scottohair/octal/Octal Schematic.pdf

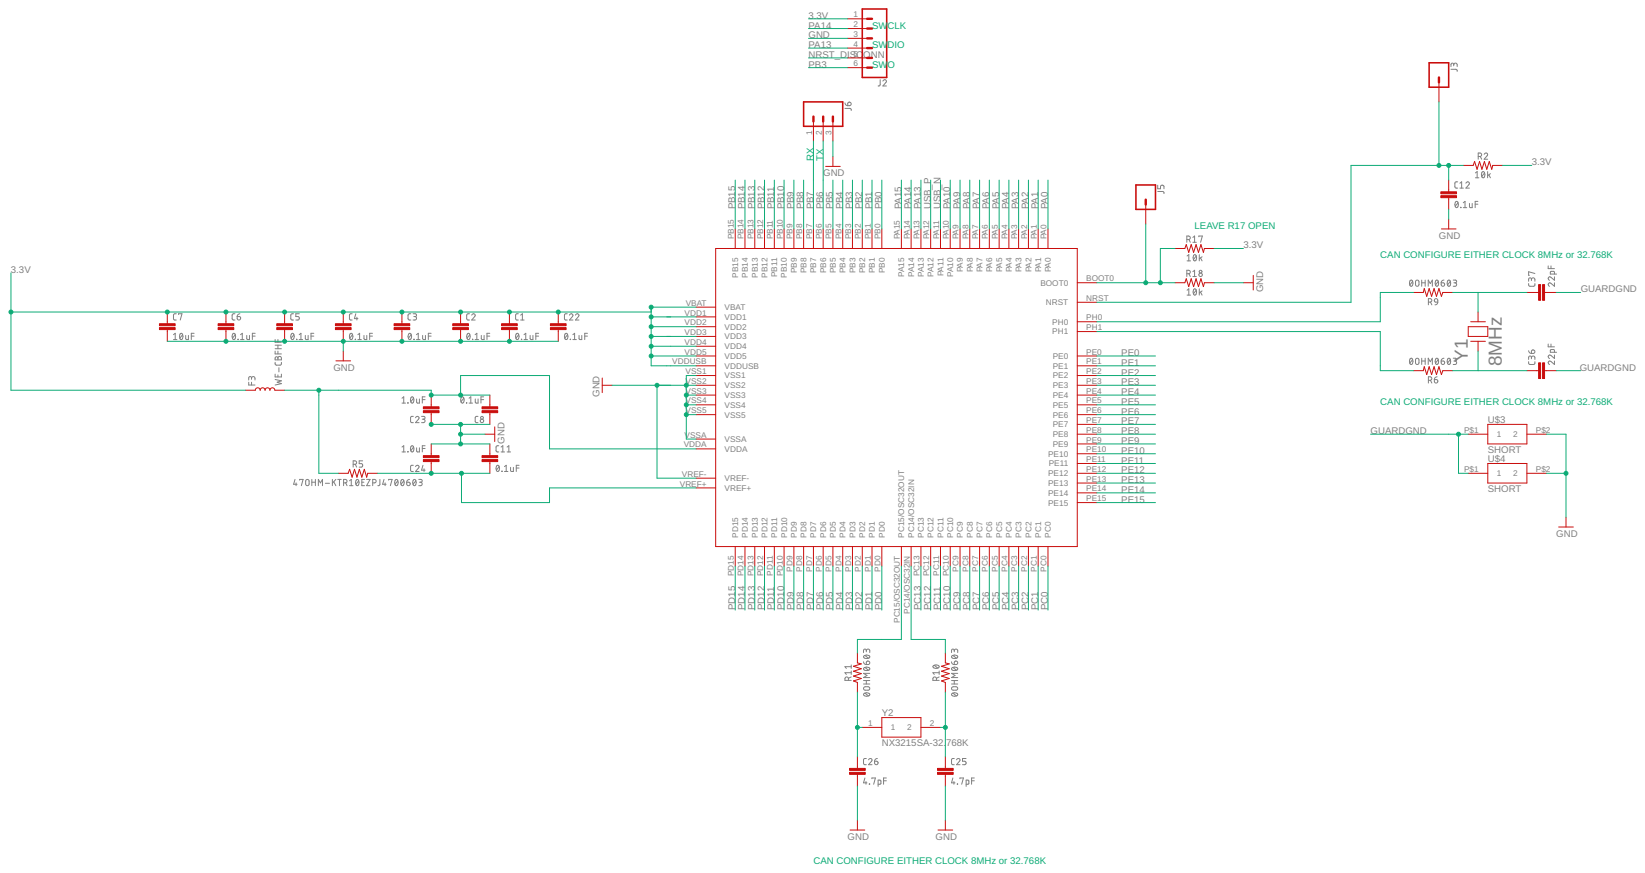
[picture p1: page 1]

8MHz GND GND GND NX3215SA-32.768K GND GND GND GND GND GND SHORT SHORT BOOT0 BOOT0 NRST NRST PA0 PA0 PA1 PA1 PA2 PA2 PA3 PA3 PA4 PA4 PA5 PA5 PA6 PA6 PA7 PA7 PA8 PA8 PA9 PA9 PA10 PA10 PA11 PA11 PA12 PA12 PA13 PA13 PA14 PA14 PA15 PA15 PB0 PB0 PB1 PB1 PB2 PB2 PB3 PB3 PB4 PB4 PB5 PB5 PB6 PB6 PB7 PB7 PB8 PB8 PB9 PB9 PB10 PB10 PB11 PB11 PB12 PB12 PB13 PB13 PB14 PB14 PB15 PB15 PC0 PC0 PC1 PC1 PC2 PC2 PC3 PC3 PC4 PC4 PC5 PC5 PC6 PC6 PC7 PC7 PC8 PC8 PC9 PC9 PC10 PC10 PC11 PC11 PC12 PC12 PC13 PC13 PC14/OSC32IN PC14/OSC32IN PC15/OSC32OUT PC15/OSC32OUT PD0 PD0 PD1 PD1 PD2 PD2 PD3 PD3 PD4 PD4 PD5 PD5 PD6 PD6 PD7 PD7 PD8 PD8 PD9 PD9 PD10 PD10 PD11 PD11 PD12 PD12 PD13 PD13 PD14 PD14 PD15 PD15 VSS5 VSS5 PE0 PE0 PE1 PE1 PE2 PE2 PE3 PE3 PE4 PE4 PE5 PE5 PE6 PE6 PE7 PE7 PE8 PE8 PE9 PE9 PE10 PE10 PE11 PE11 PE12 PE12 PE13 PE13 PE14 PE14 PE15 PE15 PH0 PH0 PH1 PH1 VBAT VBAT VSS4 VSS4 VDDUSB VDDUSB VDD1 VDD1 VDD2 VDD2 VDD3 VDD3 VDD4 VDD4 VDD5 VDD5 VSSA VSSA VDDA VDDA VREF+ VREF+ VSS1 VSS1 VSS2 VSS2 VSS3 VSS3 VREF- VREF- Y1 123456 1 1 2 2 Y2 123 1 P$1 2 P$2 U$31 P$1 2 P$2 U$4 GND 3.3V 3.3V 3.3V 3.3V PA13 PA13 PB3 PB3 PA14 PA14 NRST_DISCONN PB15 PB14 PB13 PB12 PB11 PB10 PB9 PB8 PB7 PB6 PB5 PB4 PB2 PB1 PB0 PA15 PA10 PA9 PA8 PA7 PA6 PA5 PA4 PA3 PA2 PA1 PA0 PE0 PE1 PE2 PE3 PE4 PE5 PE6 PE7 PE8 PE9 PE10 PE11 PE12 PE13 PE14 PE15 PC0 PC1 PC2 PC3 PC4 PC5 PC6 PC7 PC8 PC9 PC10 PC11 PC12 PC13 PD0 PD1 PD2 PD3 PD4 PD5 PD6 PD7 PD8 PD9 PD10 PD11 PD12 PD13 PD14 PD15 USB_P USB_N GUARDGND GUARDGND GUARDGND SWO SWCLK SWDIO CAN CONFIGURE EITHER CLOCK 8MHz or 32.768K CAN CONFIGURE EITHER CLOCK 8MHz or 32.768K CAN CONFIGURE EITHER CLOCK 8MHz or 32.768K TXRX LEAVE R17 OPEN

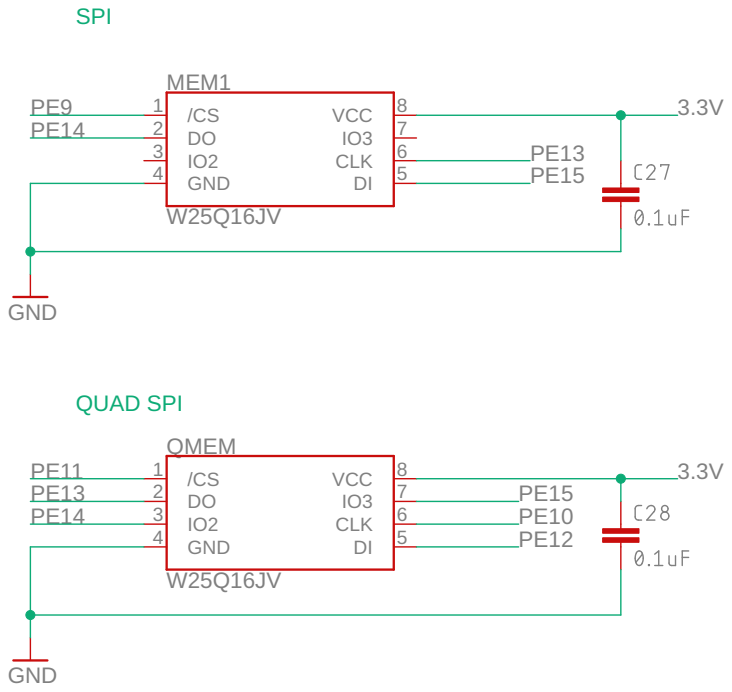
[picture p2: page 2]

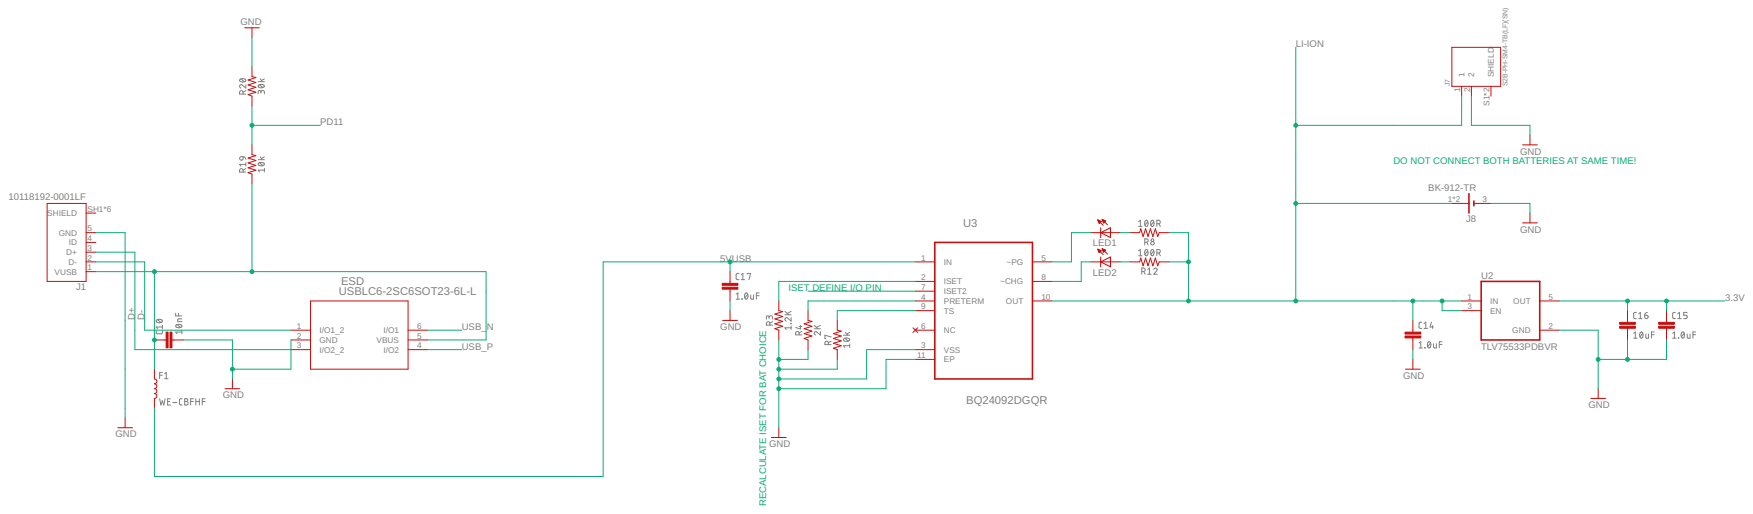
[picture p3: page 3]

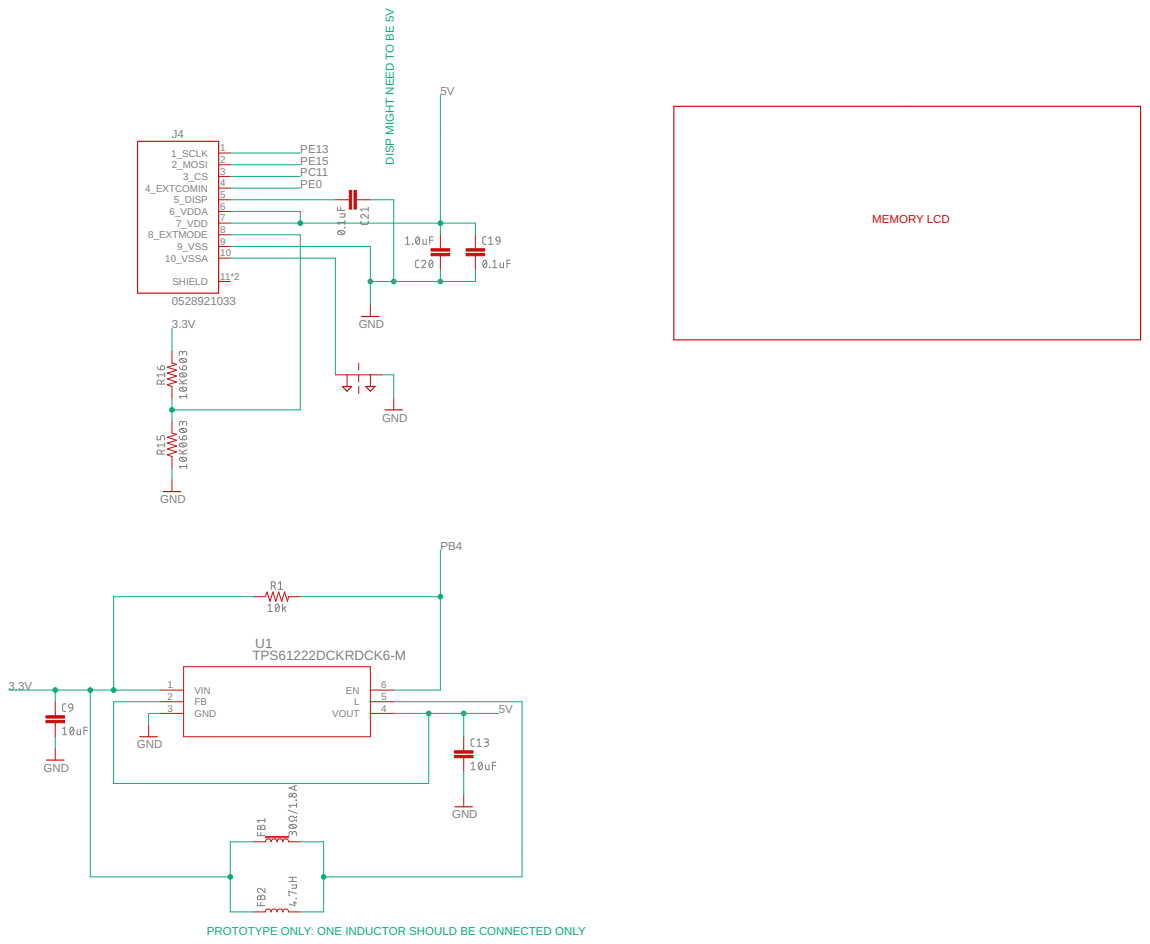
[picture p4: page 4]

PROTOTYPE ONLY: ONE INDUCTOR SHOULD BE CONNECTED ONLY

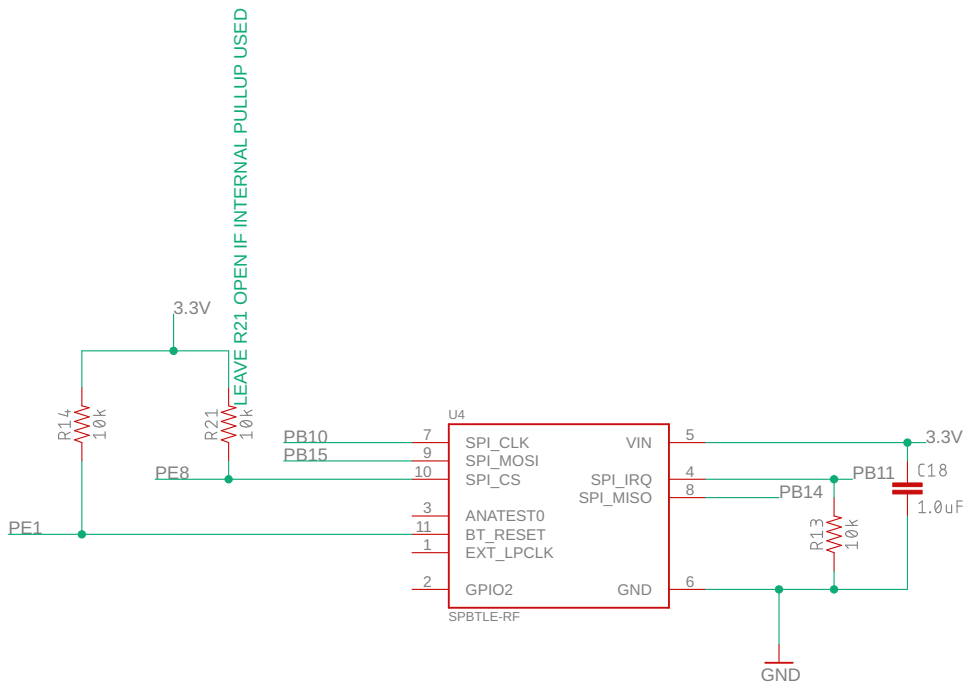
[picture p5: page 5]

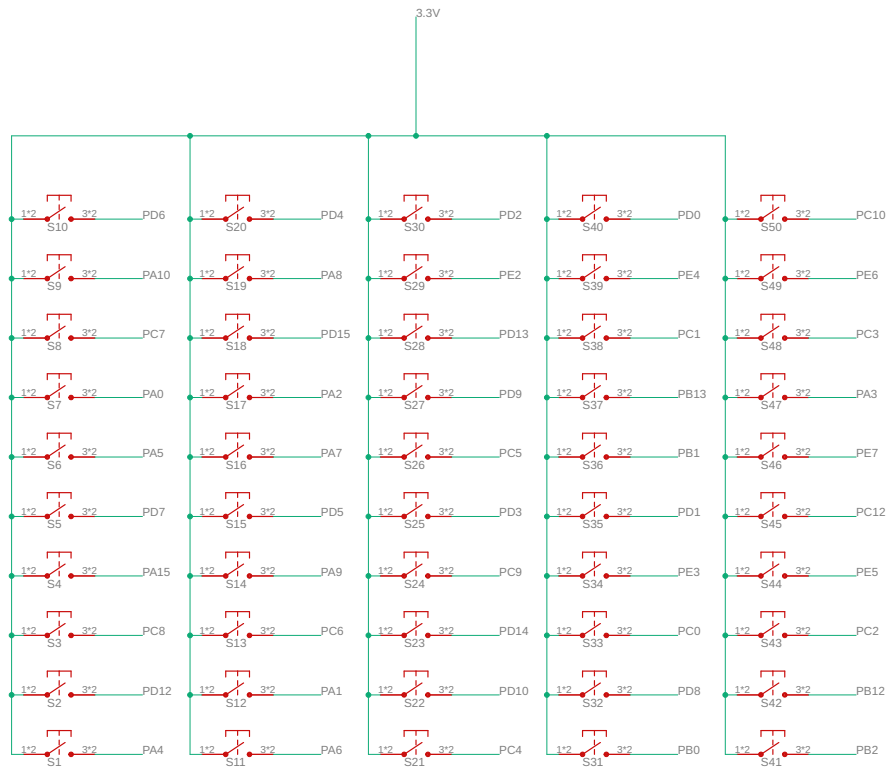
[picture p6: page 6]
