scottohair/octal/Octal.brd

## EAGLE design Octal.brd (2021-08-26)

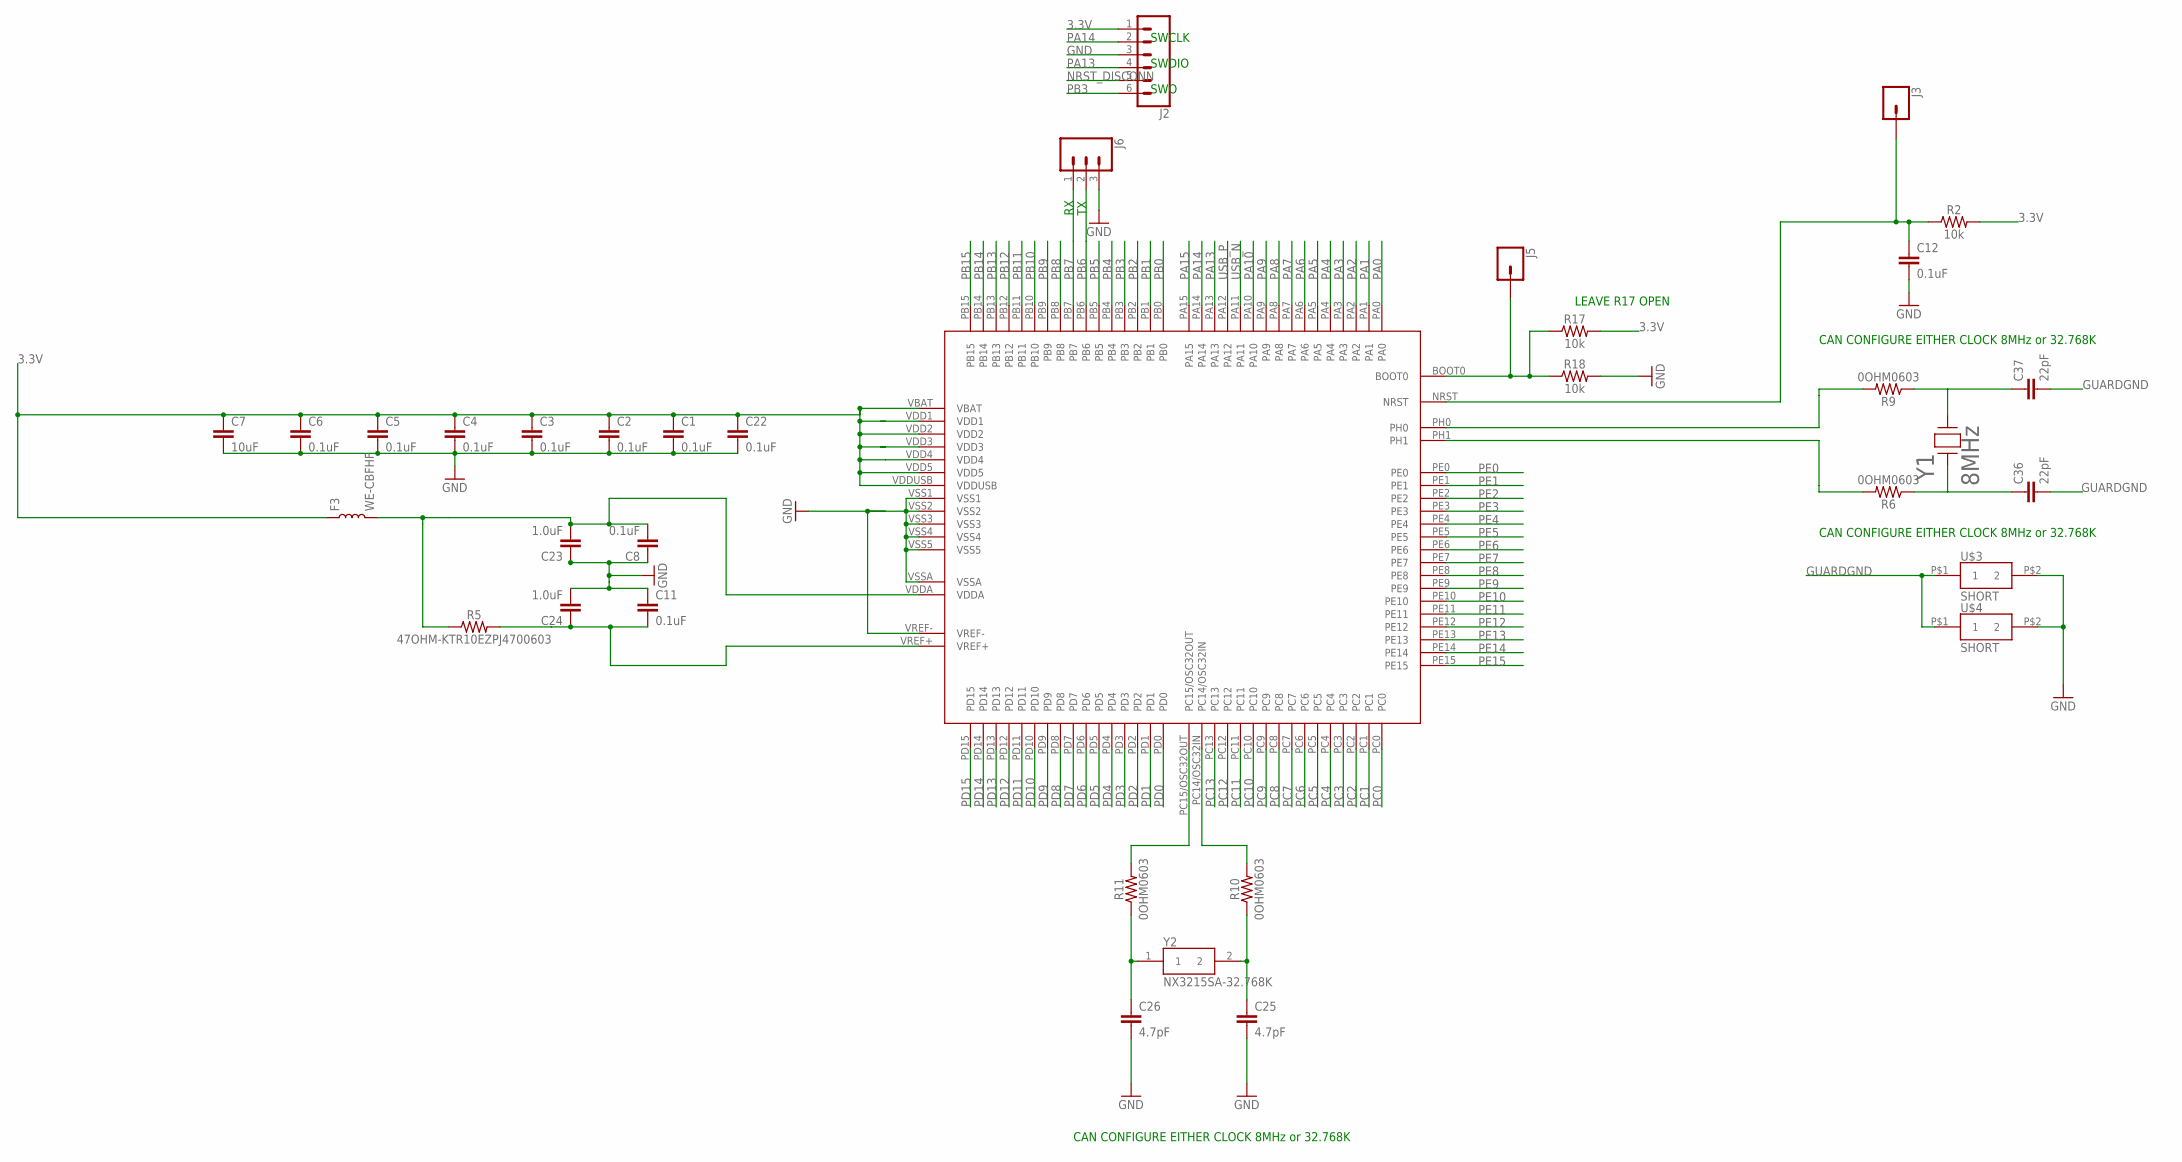
[picture p7: schematic Octal.sch, sheet 1]

Parts:
C1, C2, C3, C4, C5, C6, C8, C11, C12, C22: 0.1uF; 0603
C7: 10uF; 0603
C23, C24: 1.0uF; 0603
C25, C26: 4.7pF; 0603
C36, C37: 22pF; 0603
F3: WE-CBFHF; 0603
J2: CONN_06SILK_FEMALE_PTH; 1X06
J3, J5: CONN_01; 1X01
J6: CONN_03; 1X03
R2, R17, R18: 10k; 0603
R5: 47OHM-KTR10EZPJ4700603; 0603
R6, R9, R10, R11: 0OHM0603; 0603
U5: STM32L476VGT6; STM32L4_LQFP100
U$3, U$4: SHORT
Y1: 8MHz; CRYSTAL_HC49SDLF
Y2: NX3215SA-32.768K; NX3215SA32768KEXS00AMU00003

Connections:
3.3V: C1.1, C2.1, C3.1, C4.1, C5.1, C6.1, C7.1, C22.1, F3.1, J2.1, R2.2, R17.2, U5.VBAT, U5.VDD1, U5.VDD2, U5.VDD3, U5.VDD4, U5.VDD5, U5.VDDUSB; also elsewhere on the board
BOOT0: J5.1, R17.1, R18.1, U5.BOOT0
GND: C1.2, C2.2, C3.2, C4.2, C5.2, C6.2, C7.2, C8.1, C11.1, C12.2, C22.2, C23.1, C24.2, C25.2, C26.2, J2.3, J6.3, R18.2, U5.VREF-, U5.VSS1, U5.VSS2, U5.VSS3, U5.VSS4, U5.VSS5, U5.VSSA, U$3.P$2 (2), U$4.P$2 (2); also elsewhere on the board
GUARDGND: C36.2, C37.2, U$3.P$1 (1), U$4.P$1 (1)
unnamed: C8.2, C23.2, F3.2, R5.1, U5.VDDA
unnamed: C11.2, C24.1, R5.2, U5.VREF+
unnamed: R9.2, U5.PH0
unnamed: C37.1, R9.1, Y1.2
unnamed: C36.1, R6.1, Y1.1
unnamed: R6.2, U5.PH1
unnamed: C26.1, R11.1, Y2.1
unnamed: C25.1, R10.1, Y2.2
unnamed: R11.2, U5.PC15/OSC32OUT
unnamed: R10.2, U5.PC14/OSC32IN
NRST1: C12.1, J3.1, R2.1, U5.NRST
NRST_DISCONN: J2.5
PA0: U5.PA0; also elsewhere on the board
PA1: U5.PA1; also elsewhere on the board
PA2: U5.PA2; also elsewhere on the board
PA3: U5.PA3; also elsewhere on the board
PA4: U5.PA4; also elsewhere on the board
PA5: U5.PA5; also elsewhere on the board
PA6: U5.PA6; also elsewhere on the board
PA7: U5.PA7; also elsewhere on the board
PA8: U5.PA8; also elsewhere on the board
PA9: U5.PA9; also elsewhere on the board
PA10: U5.PA10; also elsewhere on the board
PA13: J2.4, U5.PA13
PA14: J2.2, U5.PA14
PA15: U5.PA15; also elsewhere on the board
PB0: U5.PB0; also elsewhere on the board
PB1: U5.PB1; also elsewhere on the board
PB2: U5.PB2; also elsewhere on the board
PB3: J2.6, U5.PB3
PB4: U5.PB4; also elsewhere on the board
PB5: U5.PB5
PB6: J6.2, U5.PB6
PB7: J6.1, U5.PB7
PB8: U5.PB8
PB9: U5.PB9
PB10: U5.PB10; also elsewhere on the board
PB11: U5.PB11; also elsewhere on the board
PB12: U5.PB12; also elsewhere on the board
PB13: U5.PB13; also elsewhere on the board
PB14: U5.PB14; also elsewhere on the board
PB15: U5.PB15; also elsewhere on the board
PC0: U5.PC0; also elsewhere on the board
PC1: U5.PC1; also elsewhere on the board
PC2: U5.PC2; also elsewhere on the board
PC3: U5.PC3; also elsewhere on the board
PC4: U5.PC4; also elsewhere on the board
PC5: U5.PC5; also elsewhere on the board
PC6: U5.PC6; also elsewhere on the board
PC7: U5.PC7; also elsewhere on the board
PC8: U5.PC8; also elsewhere on the board
PC9: U5.PC9; also elsewhere on the board
PC10: U5.PC10; also elsewhere on the board
PC11: U5.PC11; also elsewhere on the board
PC12: U5.PC12; also elsewhere on the board
PC13: U5.PC13
PD0: U5.PD0; also elsewhere on the board
PD1: U5.PD1; also elsewhere on the board
PD2: U5.PD2; also elsewhere on the board
PD3: U5.PD3; also elsewhere on the board
PD4: U5.PD4; also elsewhere on the board
PD5: U5.PD5; also elsewhere on the board
PD6: U5.PD6; also elsewhere on the board
PD7: U5.PD7; also elsewhere on the board
PD8: U5.PD8; also elsewhere on the board
PD9: U5.PD9; also elsewhere on the board
PD10: U5.PD10; also elsewhere on the board
PD11: U5.PD11; also elsewhere on the board
PD12: U5.PD12; also elsewhere on the board
PD13: U5.PD13; also elsewhere on the board
PD14: U5.PD14; also elsewhere on the board
PD15: U5.PD15; also elsewhere on the board
PE0: U5.PE0; also elsewhere on the board
PE1: U5.PE1; also elsewhere on the board
PE2: U5.PE2; also elsewhere on the board
PE3: U5.PE3; also elsewhere on the board
PE4: U5.PE4; also elsewhere on the board
PE5: U5.PE5; also elsewhere on the board
PE6: U5.PE6; also elsewhere on the board
PE7: U5.PE7; also elsewhere on the board
PE8: U5.PE8; also elsewhere on the board
PE9: U5.PE9; also elsewhere on the board
PE10: U5.PE10; also elsewhere on the board
PE11: U5.PE11; also elsewhere on the board
PE12: U5.PE12; also elsewhere on the board
PE13: U5.PE13; also elsewhere on the board
PE14: U5.PE14; also elsewhere on the board
PE15: U5.PE15; also elsewhere on the board
USB_N: U5.PA11; also elsewhere on the board
USB_P: U5.PA12; also elsewhere on the board

Notes on the sheet:
SWO
SWCLK
SWDIO
CAN CONFIGURE EITHER CLOCK 8MHz or 32.768K
LEAVE R17 OPEN

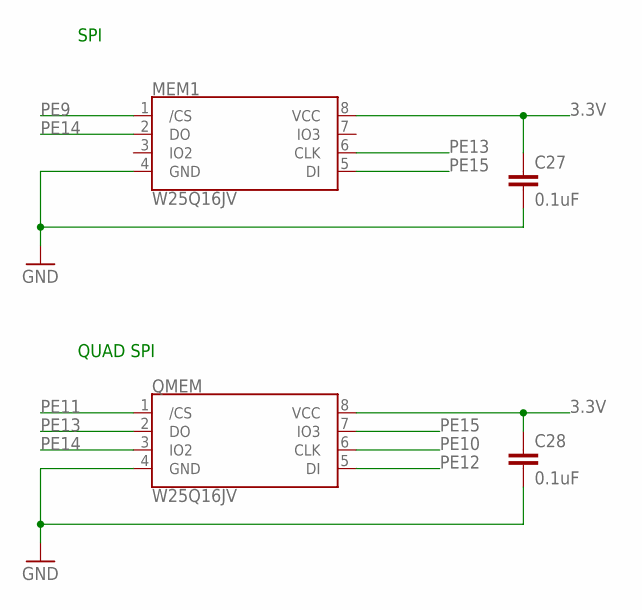
[picture p8: schematic Octal.sch, sheet 2]

Parts:
C27, C28: 0.1uF; 0603
MEM1: W25Q16JV; SOIC-8
QMEM: W25Q16JV; SOIC-8

Connections:
3.3V: C27.1, C28.1, MEM1.8 (VCC), QMEM.8 (VCC); also elsewhere on the board
GND: C27.2, C28.2, MEM1.4 (GND), QMEM.4 (GND); also elsewhere on the board
PE9: MEM1.1 (/CS); also elsewhere on the board
PE10: QMEM.6 (CLK); also elsewhere on the board
PE11: QMEM.1 (/CS); also elsewhere on the board
PE12: QMEM.5 (DI); also elsewhere on the board
PE13: MEM1.6 (CLK), QMEM.2 (DO); also elsewhere on the board
PE14: MEM1.2 (DO), QMEM.3 (IO2); also elsewhere on the board
PE15: MEM1.5 (DI), QMEM.7 (IO3); also elsewhere on the board

Notes on the sheet:
QUAD SPI
SPI

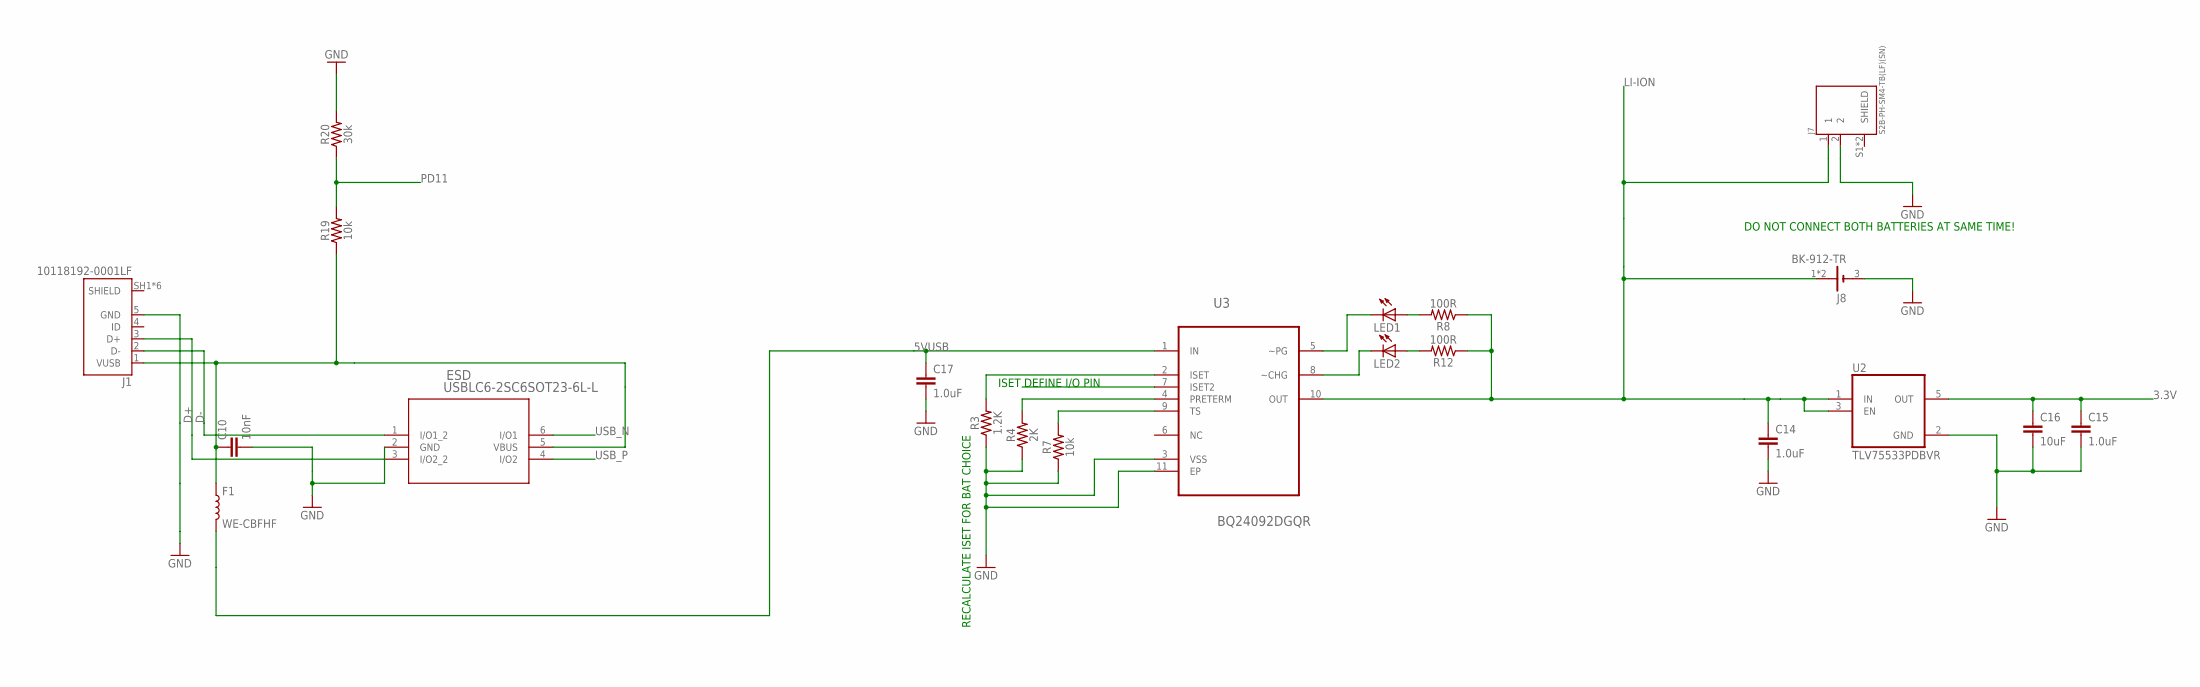
[picture p9: schematic Octal.sch, sheet 3]

Parts:
C10: 10nF; 0603
C14, C15, C17: 1.0uF; SPARKFUN-CAPACITORS_0603
C16: 10uF; 0603
ESD: USBLC6-2SC6SOT23-6L-L; SOT23-6L-L
F1: WE-CBFHF; 0603
J1: 10118192-0001LF; AMPHENOL_10118192-0001LF
J7: S2B-PH-SM4-TB(LF)(SN); JST_S2B-PH-SM4-TB(LF)(SN)
J8: BK-912-TR; MPD_BK-912-TR
LED1, LED2: LEDCHIP-LED0603; CHIP-LED0603
R3: 1.2K; SPARKFUN-RESISTORS_0603:1
R4: 2K; SPARKFUN-RESISTORS_0603:1
R7, R19: 10k; SPARKFUN-RESISTORS_0603:1
R8, R12: 100R; SPARKFUN-RESISTORS_0603:1
R20: 30k; SPARKFUN-RESISTORS_0603:1
U2: TLV75533PDBVR; SOT95P280X145-5N
U3: BQ24092DGQR; SOP50P490X110-11N

Connections:
3.3V: C15.1, C16.1, U2.5 (OUT); also elsewhere on the board
5VUSB: C17.1, F1.2, U3.1 (IN)
D+: ESD.3 (I/O2_2), J1.3 (D+)
D-: ESD.1 (I/O1_2), J1.2 (D-)
GND: C10.2, C14.2, C15.2, C16.2, C17.2, ESD.2 (GND), J1.5 (GND), J7.2, J8.3 (-), R3.1, R4.1, R7.1, R20.2, U2.2 (GND), U3.3 (VSS), U3.11 (EP); also elsewhere on the board
LI-ION: C14.1, J7.1, J8.1 (+), J8.2 (+), R8.1, R12.1, U2.1 (IN), U2.3 (EN), U3.10 (OUT)
unnamed: R3.2, U3.2 (ISET)
unnamed: R7.2, U3.9 (TS)
unnamed: R4.2, U3.4 (PRETERM)
unnamed: LED1.C, U3.5 (~PG)
unnamed: LED2.C, U3.8 (~CHG)
unnamed: LED1.A, R8.2
unnamed: LED2.A, R12.2
PD11: R19.2, R20.1; also elsewhere on the board
USB_N: ESD.6 (I/O1); also elsewhere on the board
USB_P: ESD.4 (I/O2); also elsewhere on the board
VBUS: C10.1, ESD.5 (VBUS), F1.1, J1.1 (VUSB), R19.1

Notes on the sheet:
ISET DEFINE I/O PIN
RECALCULATE ISET FOR BAT CHOICE
DO NOT CONNECT BOTH BATTERIES AT SAME TIME!

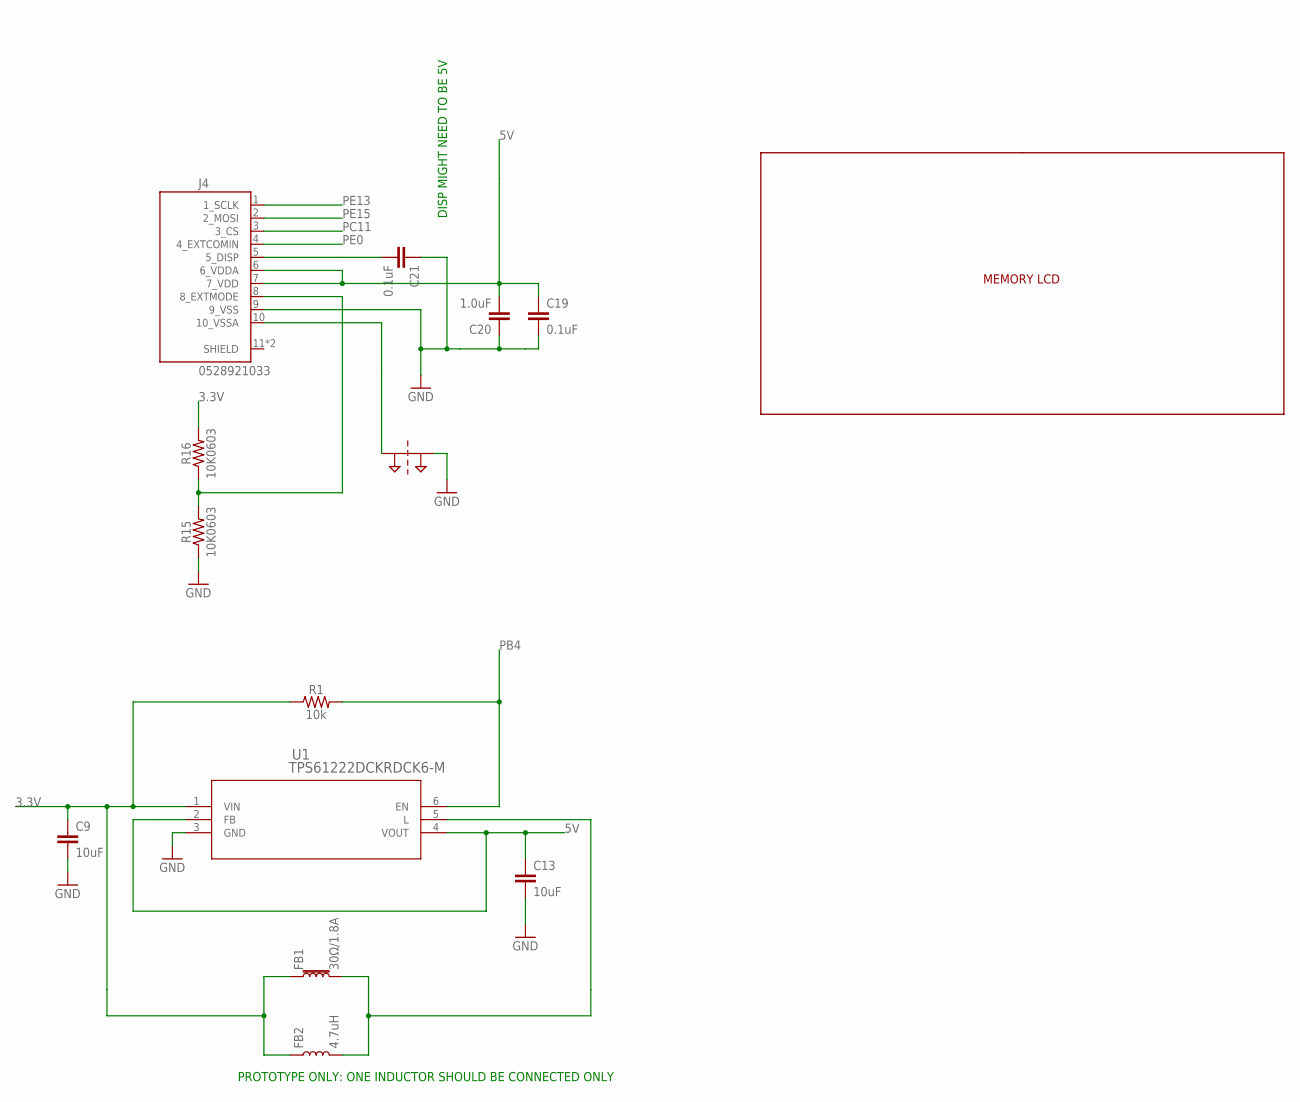
[picture p10: schematic Octal.sch, sheet 4]

Parts:
C9, C13: 10uF; 0603
C19, C21: 0.1uF; 0603
C20: 1.0uF; 0603
FB1: 30Ω/1.8A; 0603
FB2: 4.7uH; CIG22H4R7MNE
J4: 0528921033; MOLEX_0528921033
R1: 10k; SPARKFUN-RESISTORS_0603:1
R15, R16: 10K0603; 0603
SUPPLY1: 2PT_GND_TIE
U1: TPS61222DCKRDCK6-M; DCK6-M
U$2: LS027B7DH01

Connections:
3.3V: C9.1, FB1.1, FB2.1, R1.1, R16.2, U1.1 (VIN); also elsewhere on the board
5V: C13.1, C19.1, C20.2, J4.6 (6_VDDA), J4.7 (7_VDD), U1.2 (FB), U1.4 (VOUT)
ARTN: J4.10 (10_VSSA), SUPPLY1.P$1
GND: C9.2, C13.2, C19.2, C20.1, C21.1, J4.9 (9_VSS), R15.1, SUPPLY1.P$2, U1.3 (GND); also elsewhere on the board
unnamed: FB1.2, FB2.2, U1.5 (L)
unnamed: C21.2, J4.5 (5_DISP)
unnamed: J4.8 (8_EXTMODE), R15.2, R16.1
PB4: R1.2, U1.6 (EN); also elsewhere on the board
PC11: J4.3 (3_CS); also elsewhere on the board
PE0: J4.4 (4_EXTCOMIN); also elsewhere on the board
PE13: J4.1 (1_SCLK); also elsewhere on the board
PE15: J4.2 (2_MOSI); also elsewhere on the board

Notes on the sheet:
PROTOTYPE ONLY: ONE INDUCTOR SHOULD BE CONNECTED ONLY
DISP MIGHT NEED TO BE 5V

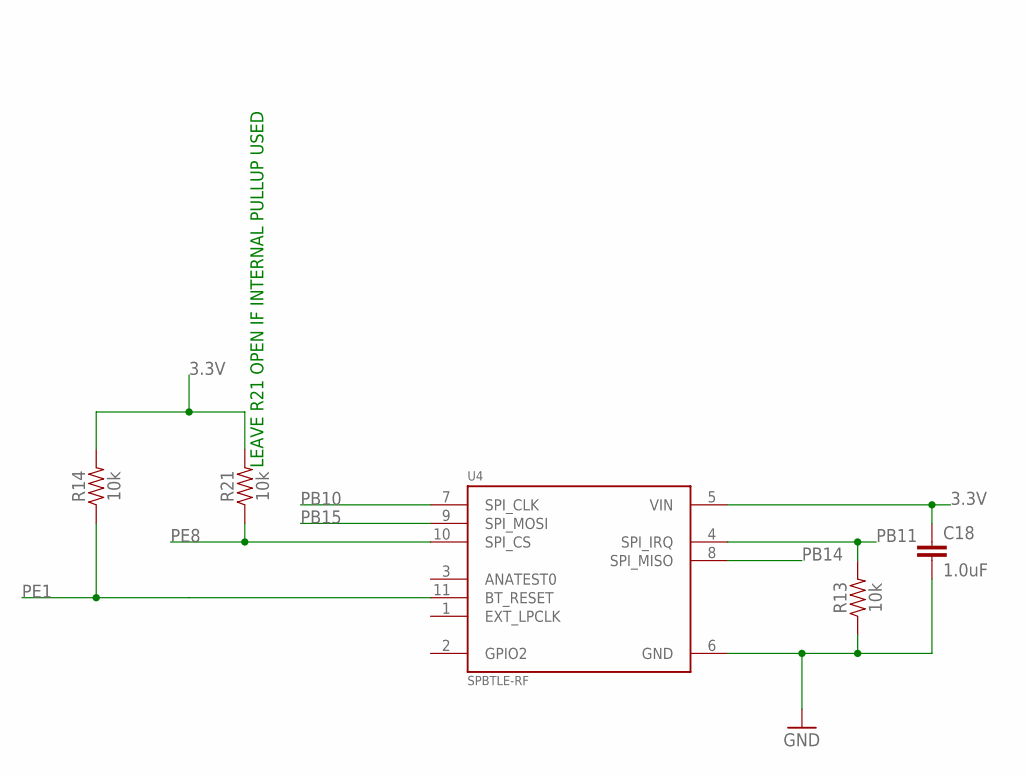
[picture p11: schematic Octal.sch, sheet 5]

Parts:
C18: 1.0uF; SPARKFUN-CAPACITORS_0603
R13, R14, R21: 10k; SPARKFUN-RESISTORS_0603:1
U4: SPBTLE-RF; XCVR_SPBTLE-RF

Connections:
3.3V: C18.1, R14.2, R21.2, U4.5 (VIN); also elsewhere on the board
GND: C18.2, R13.1, U4.6 (GND); also elsewhere on the board
PB10: U4.7 (SPI_CLK); also elsewhere on the board
PB11: R13.2, U4.4 (SPI_IRQ); also elsewhere on the board
PB14: U4.8 (SPI_MISO); also elsewhere on the board
PB15: U4.9 (SPI_MOSI); also elsewhere on the board
PE1: R14.1, U4.11 (BT_RESET); also elsewhere on the board
PE8: R21.1, U4.10 (SPI_CS); also elsewhere on the board

Notes on the sheet:
LEAVE R21 OPEN IF INTERNAL PULLUP USED

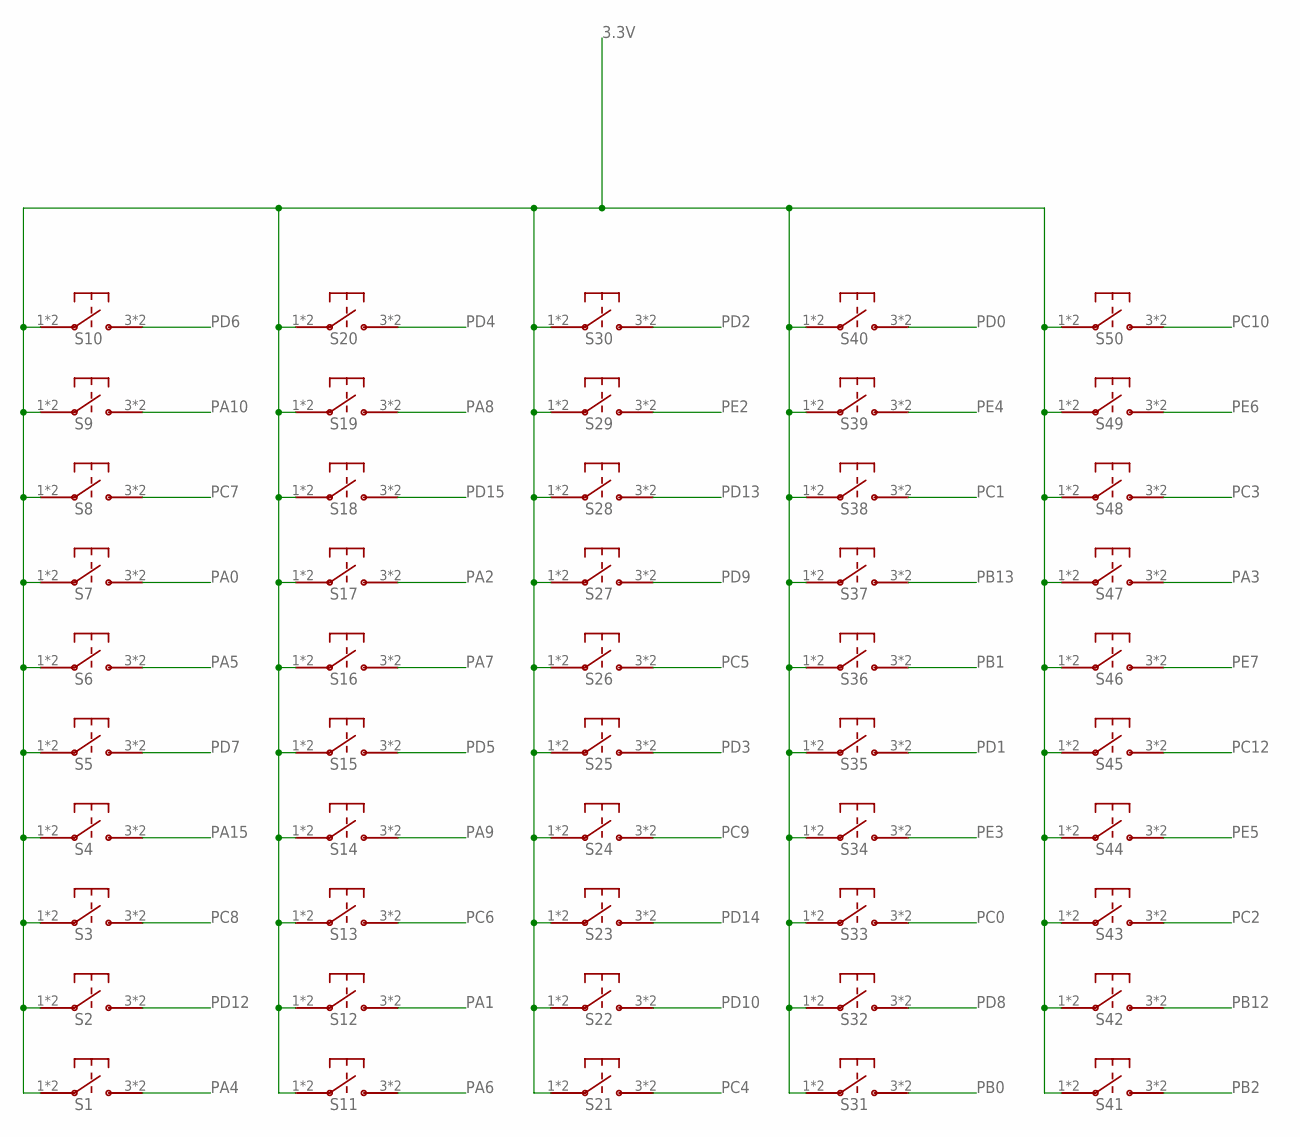
[picture p12: schematic Octal.sch, sheet 6]

Parts:
S1, S2, S3, S4, S5, S6, S7, S8, S9, S10, S11, S12, S13, S14, S15, S16, S17, S18, S19, S20, S21, S22, S23, S24, S25, S26, S27, S28, S29, S30, S31, S32, S33, S34, S35, S36, S37, S38, S39, S40, S41, S42, S43, S44, S45, S46, S47, S48, S49, S50: TL3315NF100Q

Connections:
3.3V: S1.1, S1.2, S2.1, S2.2, S3.1, S3.2, S4.1, S4.2, S5.1, S5.2, S6.1, S6.2, S7.1, S7.2, S8.1, S8.2, S9.1, S9.2, S10.1, S10.2, S11.1, S11.2, S12.1, S12.2, S13.1, S13.2, S14.1, S14.2, S15.1, S15.2, S16.1, S16.2, S17.1, S17.2, S18.1, S18.2, S19.1, S19.2, S20.1, S20.2, S21.1, S21.2, S22.1, S22.2, S23.1, S23.2, S24.1, S24.2, S25.1, S25.2, S26.1, S26.2, S27.1, S27.2, S28.1, S28.2, S29.1, S29.2, S30.1, S30.2, S31.1, S31.2, S32.1, S32.2, S33.1, S33.2, S34.1, S34.2, S35.1, S35.2, S36.1, S36.2, S37.1, S37.2, S38.1, S38.2, S39.1, S39.2, S40.1, S40.2, S41.1, S41.2, S42.1, S42.2, S43.1, S43.2, S44.1, S44.2, S45.1, S45.2, S46.1, S46.2, S47.1, S47.2, S48.1, S48.2, S49.1, S49.2, S50.1, S50.2; also elsewhere on the board
PA0: S7.3, S7.4; also elsewhere on the board
PA1: S12.3, S12.4; also elsewhere on the board
PA2: S17.3, S17.4; also elsewhere on the board
PA3: S47.3, S47.4; also elsewhere on the board
PA4: S1.3, S1.4; also elsewhere on the board
PA5: S6.3, S6.4; also elsewhere on the board
PA6: S11.3, S11.4; also elsewhere on the board
PA7: S16.3, S16.4; also elsewhere on the board
PA8: S19.3, S19.4; also elsewhere on the board
PA9: S14.3, S14.4; also elsewhere on the board
PA10: S9.3, S9.4; also elsewhere on the board
PA15: S4.3, S4.4; also elsewhere on the board
PB0: S31.3, S31.4; also elsewhere on the board
PB1: S36.3, S36.4; also elsewhere on the board
PB2: S41.3, S41.4; also elsewhere on the board
PB12: S42.3, S42.4; also elsewhere on the board
PB13: S37.3, S37.4; also elsewhere on the board
PC0: S33.3, S33.4; also elsewhere on the board
PC1: S38.3, S38.4; also elsewhere on the board
PC2: S43.3, S43.4; also elsewhere on the board
PC3: S48.3, S48.4; also elsewhere on the board
PC4: S21.3, S21.4; also elsewhere on the board
PC5: S26.3, S26.4; also elsewhere on the board
PC6: S13.3, S13.4; also elsewhere on the board
PC7: S8.3, S8.4; also elsewhere on the board
PC8: S3.3, S3.4; also elsewhere on the board
PC9: S24.3, S24.4; also elsewhere on the board
PC10: S50.3, S50.4; also elsewhere on the board
PC12: S45.3, S45.4; also elsewhere on the board
PD0: S40.3, S40.4; also elsewhere on the board
PD1: S35.3, S35.4; also elsewhere on the board
PD2: S30.3, S30.4; also elsewhere on the board
PD3: S25.3, S25.4; also elsewhere on the board
PD4: S20.3, S20.4; also elsewhere on the board
PD5: S15.3, S15.4; also elsewhere on the board
PD6: S10.3, S10.4; also elsewhere on the board
PD7: S5.3, S5.4; also elsewhere on the board
PD8: S32.3, S32.4; also elsewhere on the board
PD9: S27.3, S27.4; also elsewhere on the board
PD10: S22.3, S22.4; also elsewhere on the board
PD12: S2.3, S2.4; also elsewhere on the board
PD13: S28.3, S28.4; also elsewhere on the board
PD14: S23.3, S23.4; also elsewhere on the board
PD15: S18.3, S18.4; also elsewhere on the board
PE2: S29.3, S29.4; also elsewhere on the board
PE3: S34.3, S34.4; also elsewhere on the board
PE4: S39.3, S39.4; also elsewhere on the board
PE5: S44.3, S44.4; also elsewhere on the board
PE6: S49.3, S49.4; also elsewhere on the board
PE7: S46.3, S46.4; also elsewhere on the board

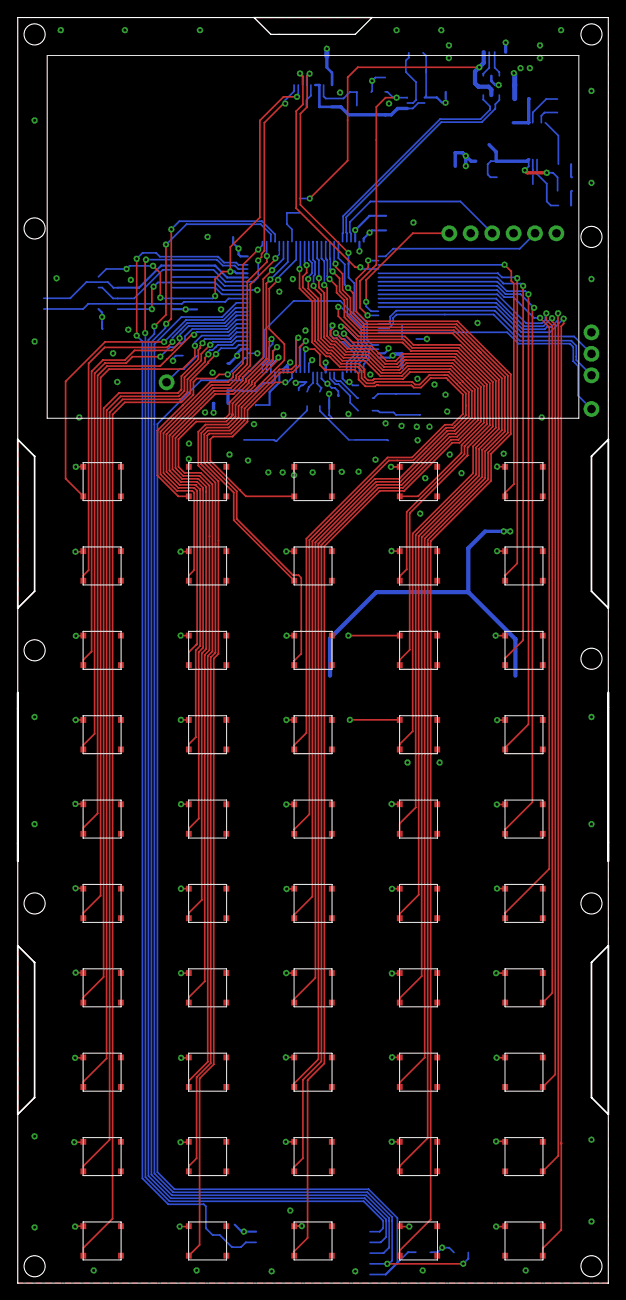
[picture p13: board Octal.brd from above]

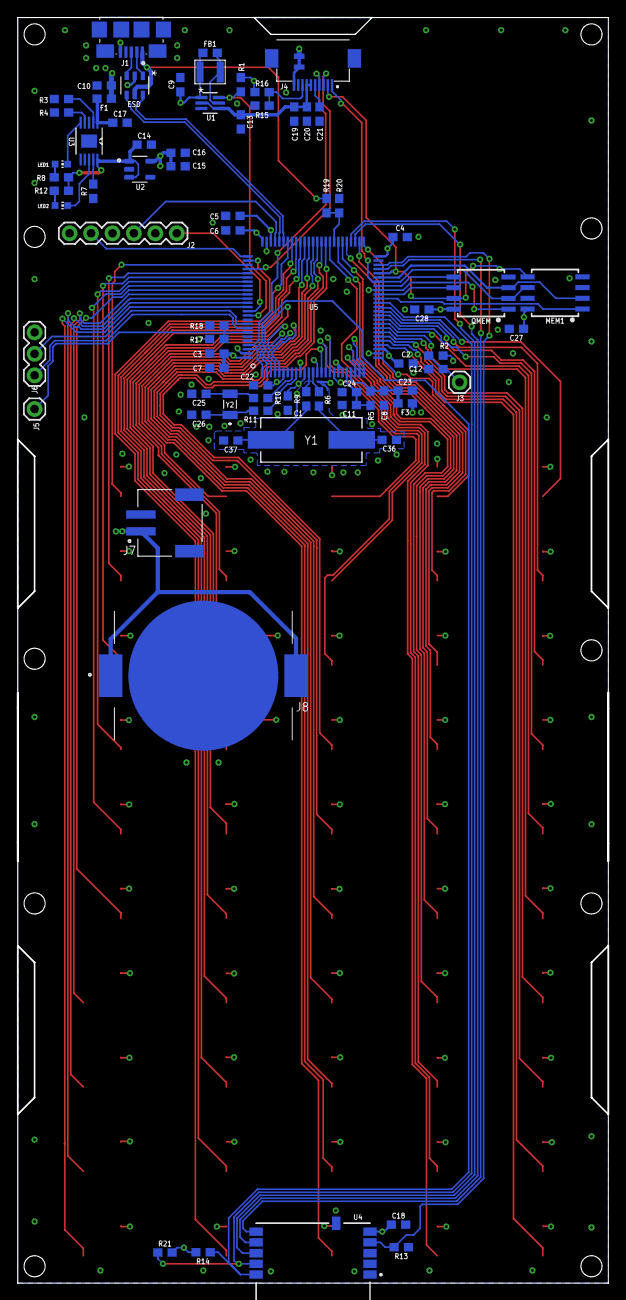
[picture p14: board Octal.brd from below]

Board: 4 copper layers, 70.0 x 150.0 mm, 129 parts (78 on the bottom side), 106 nets.
