scottohair/octal/LS027B7DH01_Breakout.brd

## EAGLE design LS027B7DH01_Breakout.brd (2021-08-26)

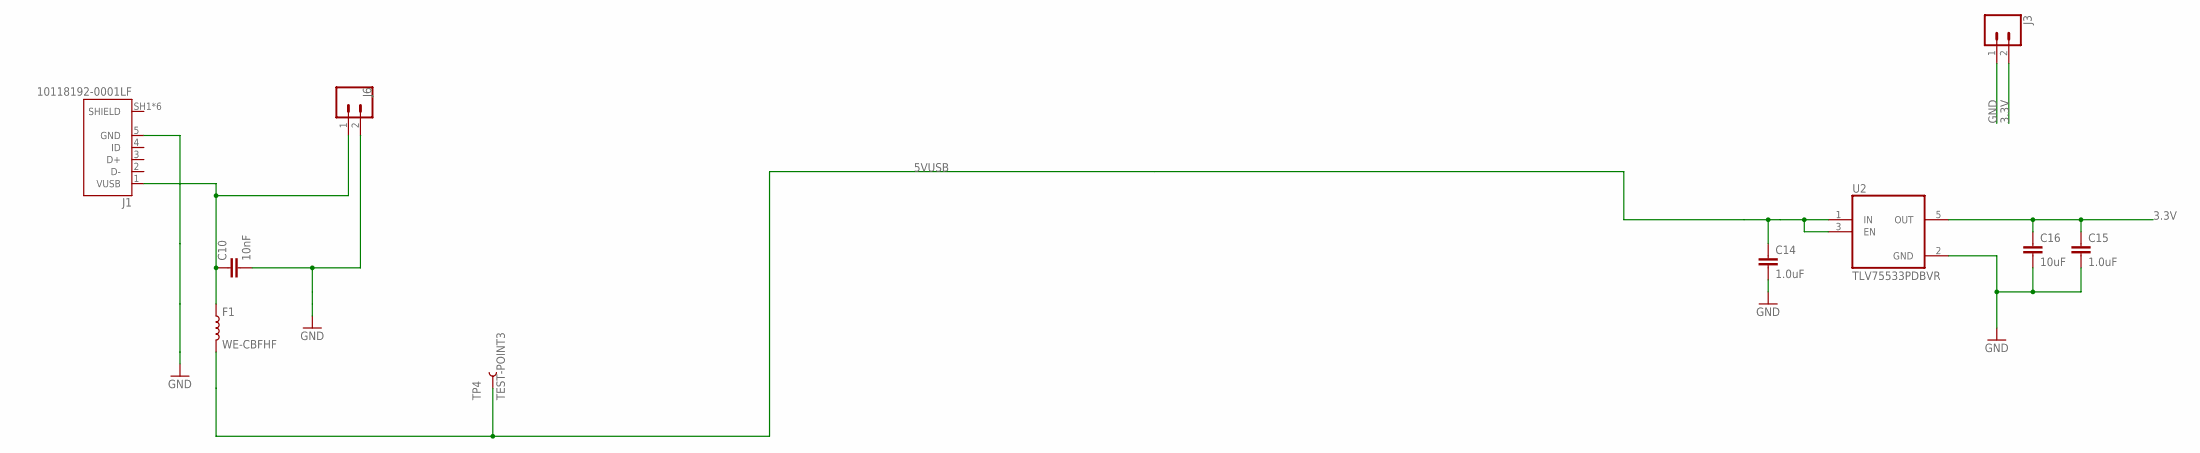
[picture p15: schematic LS027B7DH01_Breakout.sch, sheet 1]

Parts:
C10: 10nF; 0603
C14, C15: 1.0uF; SPARKFUN-CAPACITORS_0603
C16: 10uF; 0603
F1: WE-CBFHF; 0603
J1: 10118192-0001LF; AMPHENOL_10118192-0001LF
J3, J6: CONN_02; 1X02
TP4: TEST-POINT3; PAD.03X.03
U2: TLV75533PDBVR; SOT95P280X145-5N

Connections:
3.3V: C15.1, C16.1, J3.2, U2.5 (OUT); also elsewhere on the board
5VUSB: C14.1, F1.2, TP4.P$1, U2.1 (IN), U2.3 (EN)
GND: C10.2, C14.2, C15.2, C16.2, J1.5 (GND), J3.1, J6.2, U2.2 (GND); also elsewhere on the board
VBUS: C10.1, F1.1, J1.1 (VUSB), J6.1

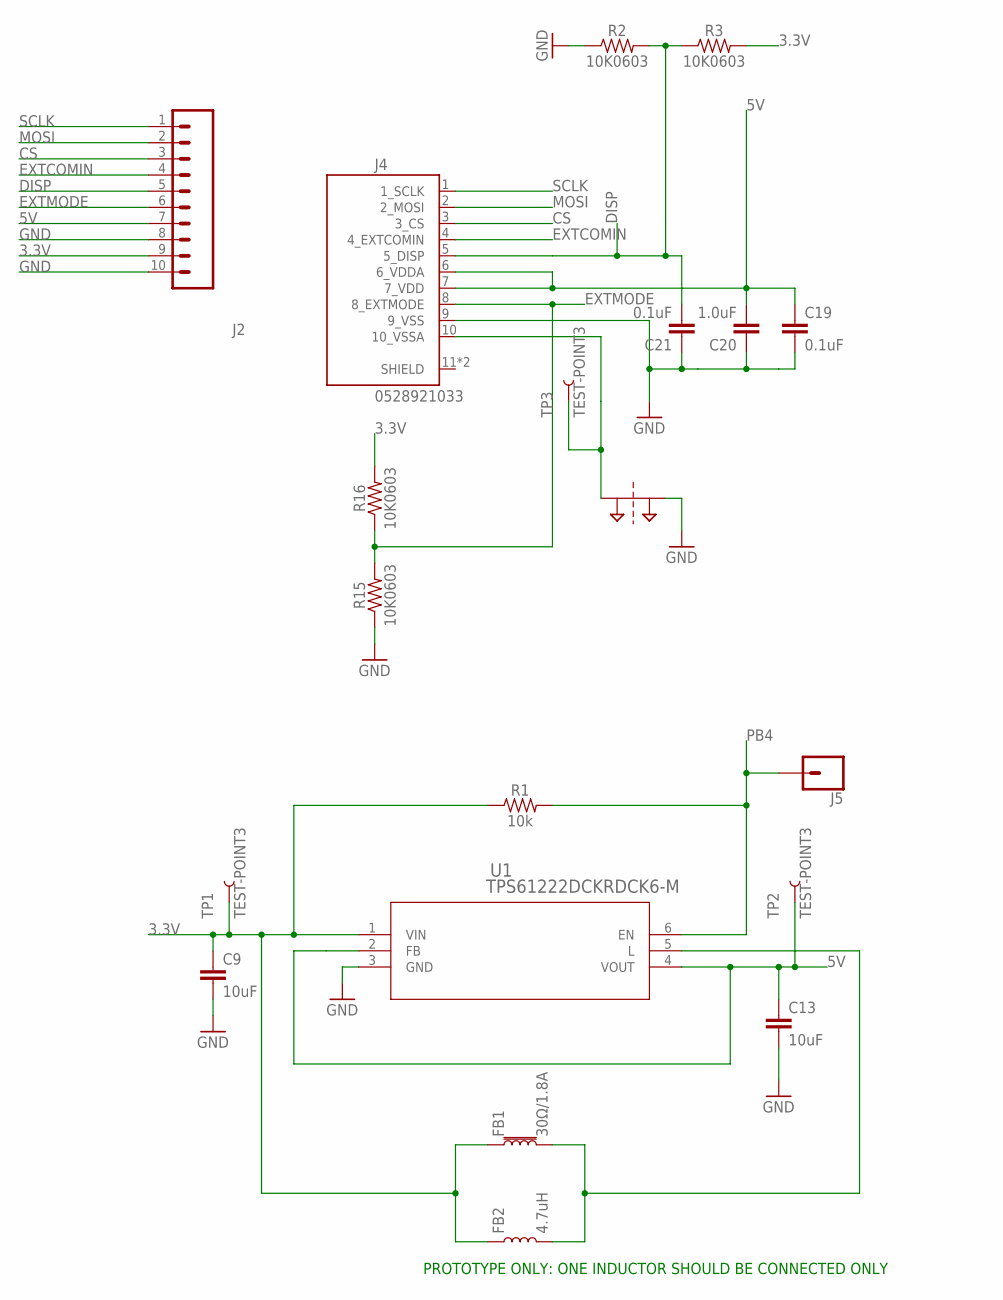
[picture p16: schematic LS027B7DH01_Breakout.sch, sheet 2]

Parts:
C9, C13: 10uF; 0603
C19, C21: 0.1uF; 0603
C20: 1.0uF; 0603
FB1: 30Ω/1.8A; 0603
FB2: 4.7uH; CIG22H4R7MNE
J2: CONN_10"; 1X10
J4: 0528921033; MOLEX_0528921033
J5: CONN_01; 1X01
R1: 10k; SPARKFUN-RESISTORS_0603:1
R2, R3, R15, R16: 10K0603; 0603
SUPPLY1: 2PT_GND_TIE
TP1, TP2, TP3: TEST-POINT3; PAD.03X.03
U1: TPS61222DCKRDCK6-M; DCK6-M

Connections:
3.3V: C9.1, FB1.1, FB2.1, J2.9, R1.1, R3.2, R16.2, TP1.P$1, U1.1 (VIN); also elsewhere on the board
5V: C13.1, C19.1, C20.2, J2.7, J4.6 (6_VDDA), J4.7 (7_VDD), TP2.P$1, U1.2 (FB), U1.4 (VOUT)
ARTN: J4.10 (10_VSSA), SUPPLY1.P$1, TP3.P$1
CS: J2.3, J4.3 (3_CS)
DISP: C21.2, J2.5, J4.5 (5_DISP), R2.2, R3.1
EXTCOMIN: J2.4, J4.4 (4_EXTCOMIN)
EXTMODE: J2.6, J4.8 (8_EXTMODE), R15.2, R16.1
GND: C9.2, C13.2, C19.2, C20.1, C21.1, J2.8, J2.10, J4.9 (9_VSS), R2.1, R15.1, SUPPLY1.P$2, U1.3 (GND); also elsewhere on the board
MOSI: J2.2, J4.2 (2_MOSI)
unnamed: FB1.2, FB2.2, U1.5 (L)
PB4: J5.1, R1.2, U1.6 (EN)
SCLK: J2.1, J4.1 (1_SCLK)

Notes on the sheet:
PROTOTYPE ONLY: ONE INDUCTOR SHOULD BE CONNECTED ONLY

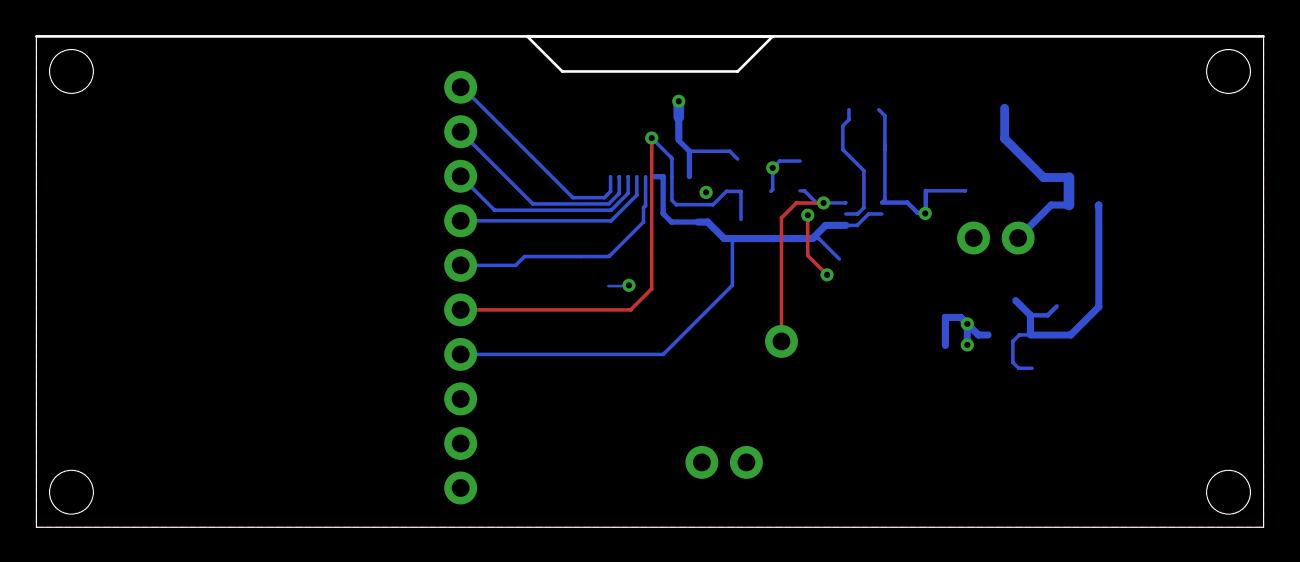
[picture p17: board LS027B7DH01_Breakout.brd from above]

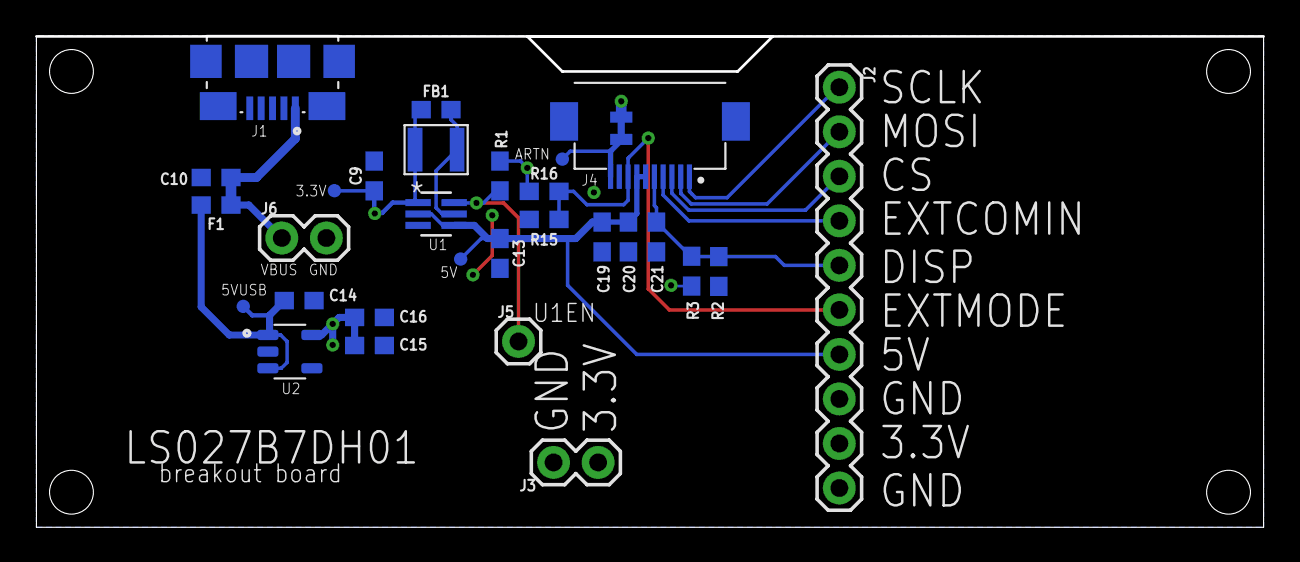
[picture p18: board LS027B7DH01_Breakout.brd from below]

Board: 2 copper layers, 70.0 x 28.0 mm, 30 parts (30 on the bottom side), 14 nets.
