scottohair/octal/Octal Source/mbed_config.h

/*
 * mbed SDK
 * Copyright (c) 2017 ARM Limited
 *
 * Licensed under the Apache License, Version 2.0 (the "License");
 * you may not use this file except in compliance with the License.
 * You may obtain a copy of the License at
 *
 * http://www.apache.org/licenses/LICENSE-2.0
 *
 * Unless required by applicable law or agreed to in writing, software
 * distributed under the License is distributed on an "AS IS" BASIS,
 * WITHOUT WARRANTIES OR CONDITIONS OF ANY KIND, either express or implied.
 * See the License for the specific language governing permissions and
 * limitations under the License.
 */

// Automatically generated configuration file.
// DO NOT EDIT, content will be overwritten.

#ifndef __MBED_CONFIG_DATA__
#define __MBED_CONFIG_DATA__

// Configuration parameters
#define CLOCK_SOURCE                                       USE_PLL_MSI                                                                    // set by target:DISCO_L476VG
#define LPTICKER_DELAY_TICKS                               4                                                                              // set by target:DISCO_L476VG
#define MBED_CONF_PLATFORM_CRASH_CAPTURE_ENABLED           0                                                                              // set by library:platform
#define MBED_CONF_PLATFORM_CTHUNK_COUNT_MAX                8                                                                              // set by library:platform
#define MBED_CONF_PLATFORM_DEFAULT_SERIAL_BAUD_RATE        9600                                                                           // set by library:platform
#define MBED_CONF_PLATFORM_ERROR_ALL_THREADS_INFO          0                                                                              // set by library:platform
#define MBED_CONF_PLATFORM_ERROR_DECODE_HTTP_URL_STR       "\nFor more info, visit: https://armmbed.github.io/mbedos-error/?error=0x%08X" // set by library:platform
#define MBED_CONF_PLATFORM_ERROR_FILENAME_CAPTURE_ENABLED  0                                                                              // set by library:platform
#define MBED_CONF_PLATFORM_ERROR_HIST_ENABLED              0                                                                              // set by library:platform
#define MBED_CONF_PLATFORM_ERROR_HIST_SIZE                 4                                                                              // set by library:platform
#define MBED_CONF_PLATFORM_ERROR_REBOOT_MAX                1                                                                              // set by library:platform
#define MBED_CONF_PLATFORM_FATAL_ERROR_AUTO_REBOOT_ENABLED 0                                                                              // set by library:platform
#define MBED_CONF_PLATFORM_FORCE_NON_COPYABLE_ERROR        0                                                                              // set by library:platform
#define MBED_CONF_PLATFORM_MAX_ERROR_FILENAME_LEN          16                                                                             // set by library:platform
#define MBED_CONF_PLATFORM_POLL_USE_LOWPOWER_TIMER         0                                                                              // set by library:platform
#define MBED_CONF_PLATFORM_STDIO_BAUD_RATE                 9600                                                                           // set by library:platform
#define MBED_CONF_PLATFORM_STDIO_BUFFERED_SERIAL           0                                                                              // set by library:platform
#define MBED_CONF_PLATFORM_STDIO_CONVERT_NEWLINES          0                                                                              // set by library:platform
#define MBED_CONF_PLATFORM_STDIO_CONVERT_TTY_NEWLINES      0                                                                              // set by library:platform
#define MBED_CONF_PLATFORM_STDIO_FLUSH_AT_EXIT             1                                                                              // set by library:platform
#define MBED_CONF_PLATFORM_USE_MPU                         1                                                                              // set by library:platform
#define MBED_CONF_TARGET_BOOT_STACK_SIZE                   0x1000                                                                         // set by target:Target
#define MBED_CONF_TARGET_DEEP_SLEEP_LATENCY                3                                                                              // set by target:FAMILY_STM32
#define MBED_CONF_TARGET_LPTICKER_LPTIM                    1                                                                              // set by target:DISCO_L476VG
#define MBED_CONF_TARGET_LPTICKER_LPTIM_CLOCK              1                                                                              // set by target:FAMILY_STM32
#define MBED_CONF_TARGET_LPUART_CLOCK_SOURCE               USE_LPUART_CLK_LSE|USE_LPUART_CLK_PCLK1                                        // set by target:FAMILY_STM32
#define MBED_CONF_TARGET_LSE_AVAILABLE                     1                                                                              // set by target:FAMILY_STM32
#define MBED_CONF_TARGET_MPU_ROM_END                       0x0fffffff                                                                     // set by target:Target

#endif
