scottohair/octal/(commit log)

2021-08-26 Add files via upload
    Added Octal STM32L4 calculator design, LS027B7DH01 breakout board and BOM for Octal project
    [LS027B7DH01_Breakout.brd, LS027B7DH01_Breakout.sch, Octal.brd, Octal.sch]
2021-08-26 Add files via upload
    Adding PDF of schematic
